Kaiapuni/ME-507-Project/README.md

# ME-507-Project
Controls a strip of Neopixel LEDs to respond to the motion of the wearer
