Kaiapuni/ME-507-Project/Eagle Files/ME507Board.png

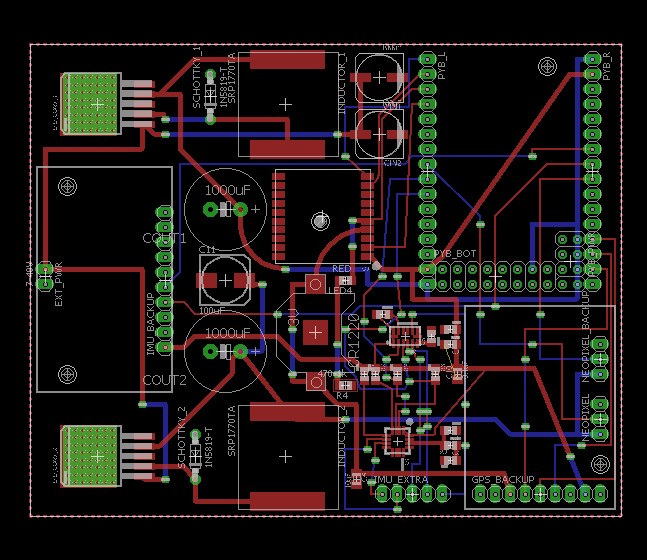
Eagle Files/ME507Board.png
