Kaiapuni/ME-507-Project/Eagle Files/ME507Schematic.png

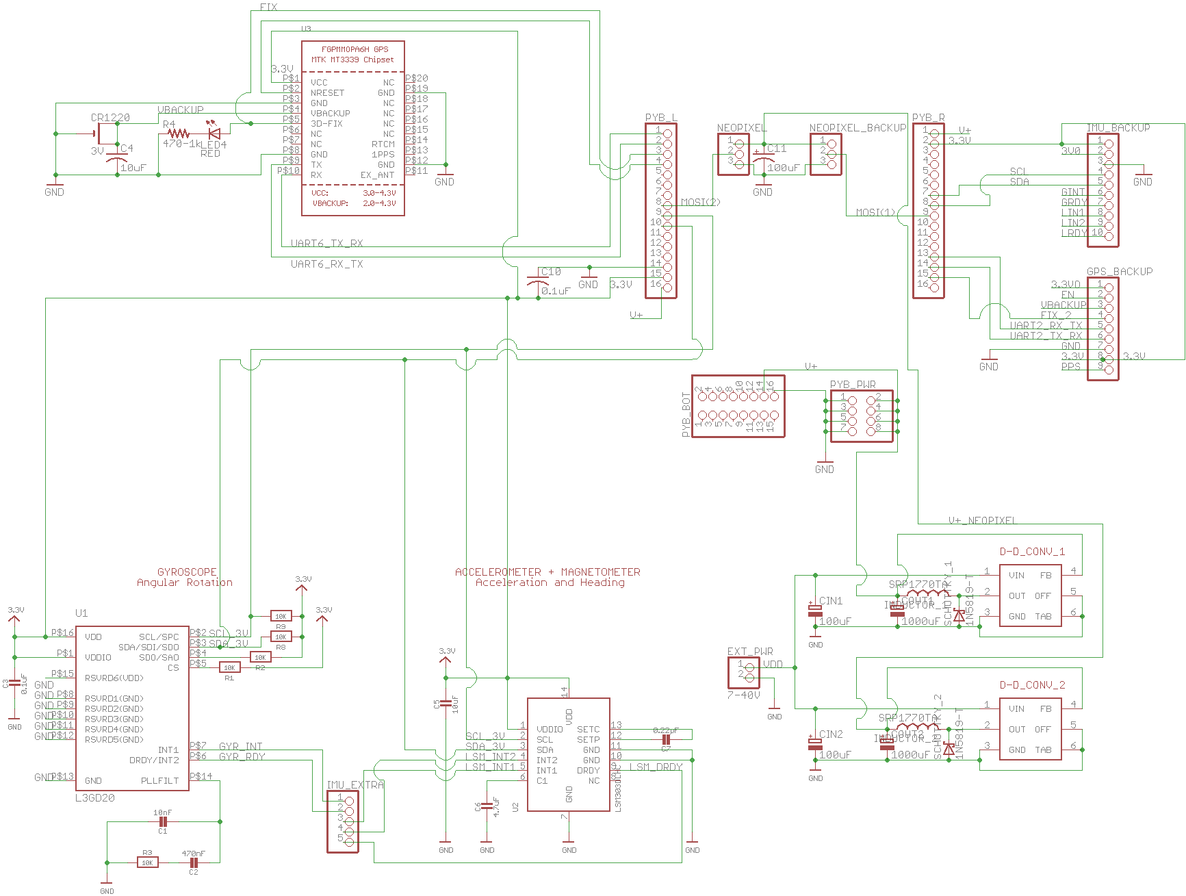
Eagle Files/ME507Schematic.png
