Kaiapuni/ME-507-Project/Eagle Files/Me507Project.brd

## EAGLE design Eagle Files/Me507Project.brd (2016-12-14)

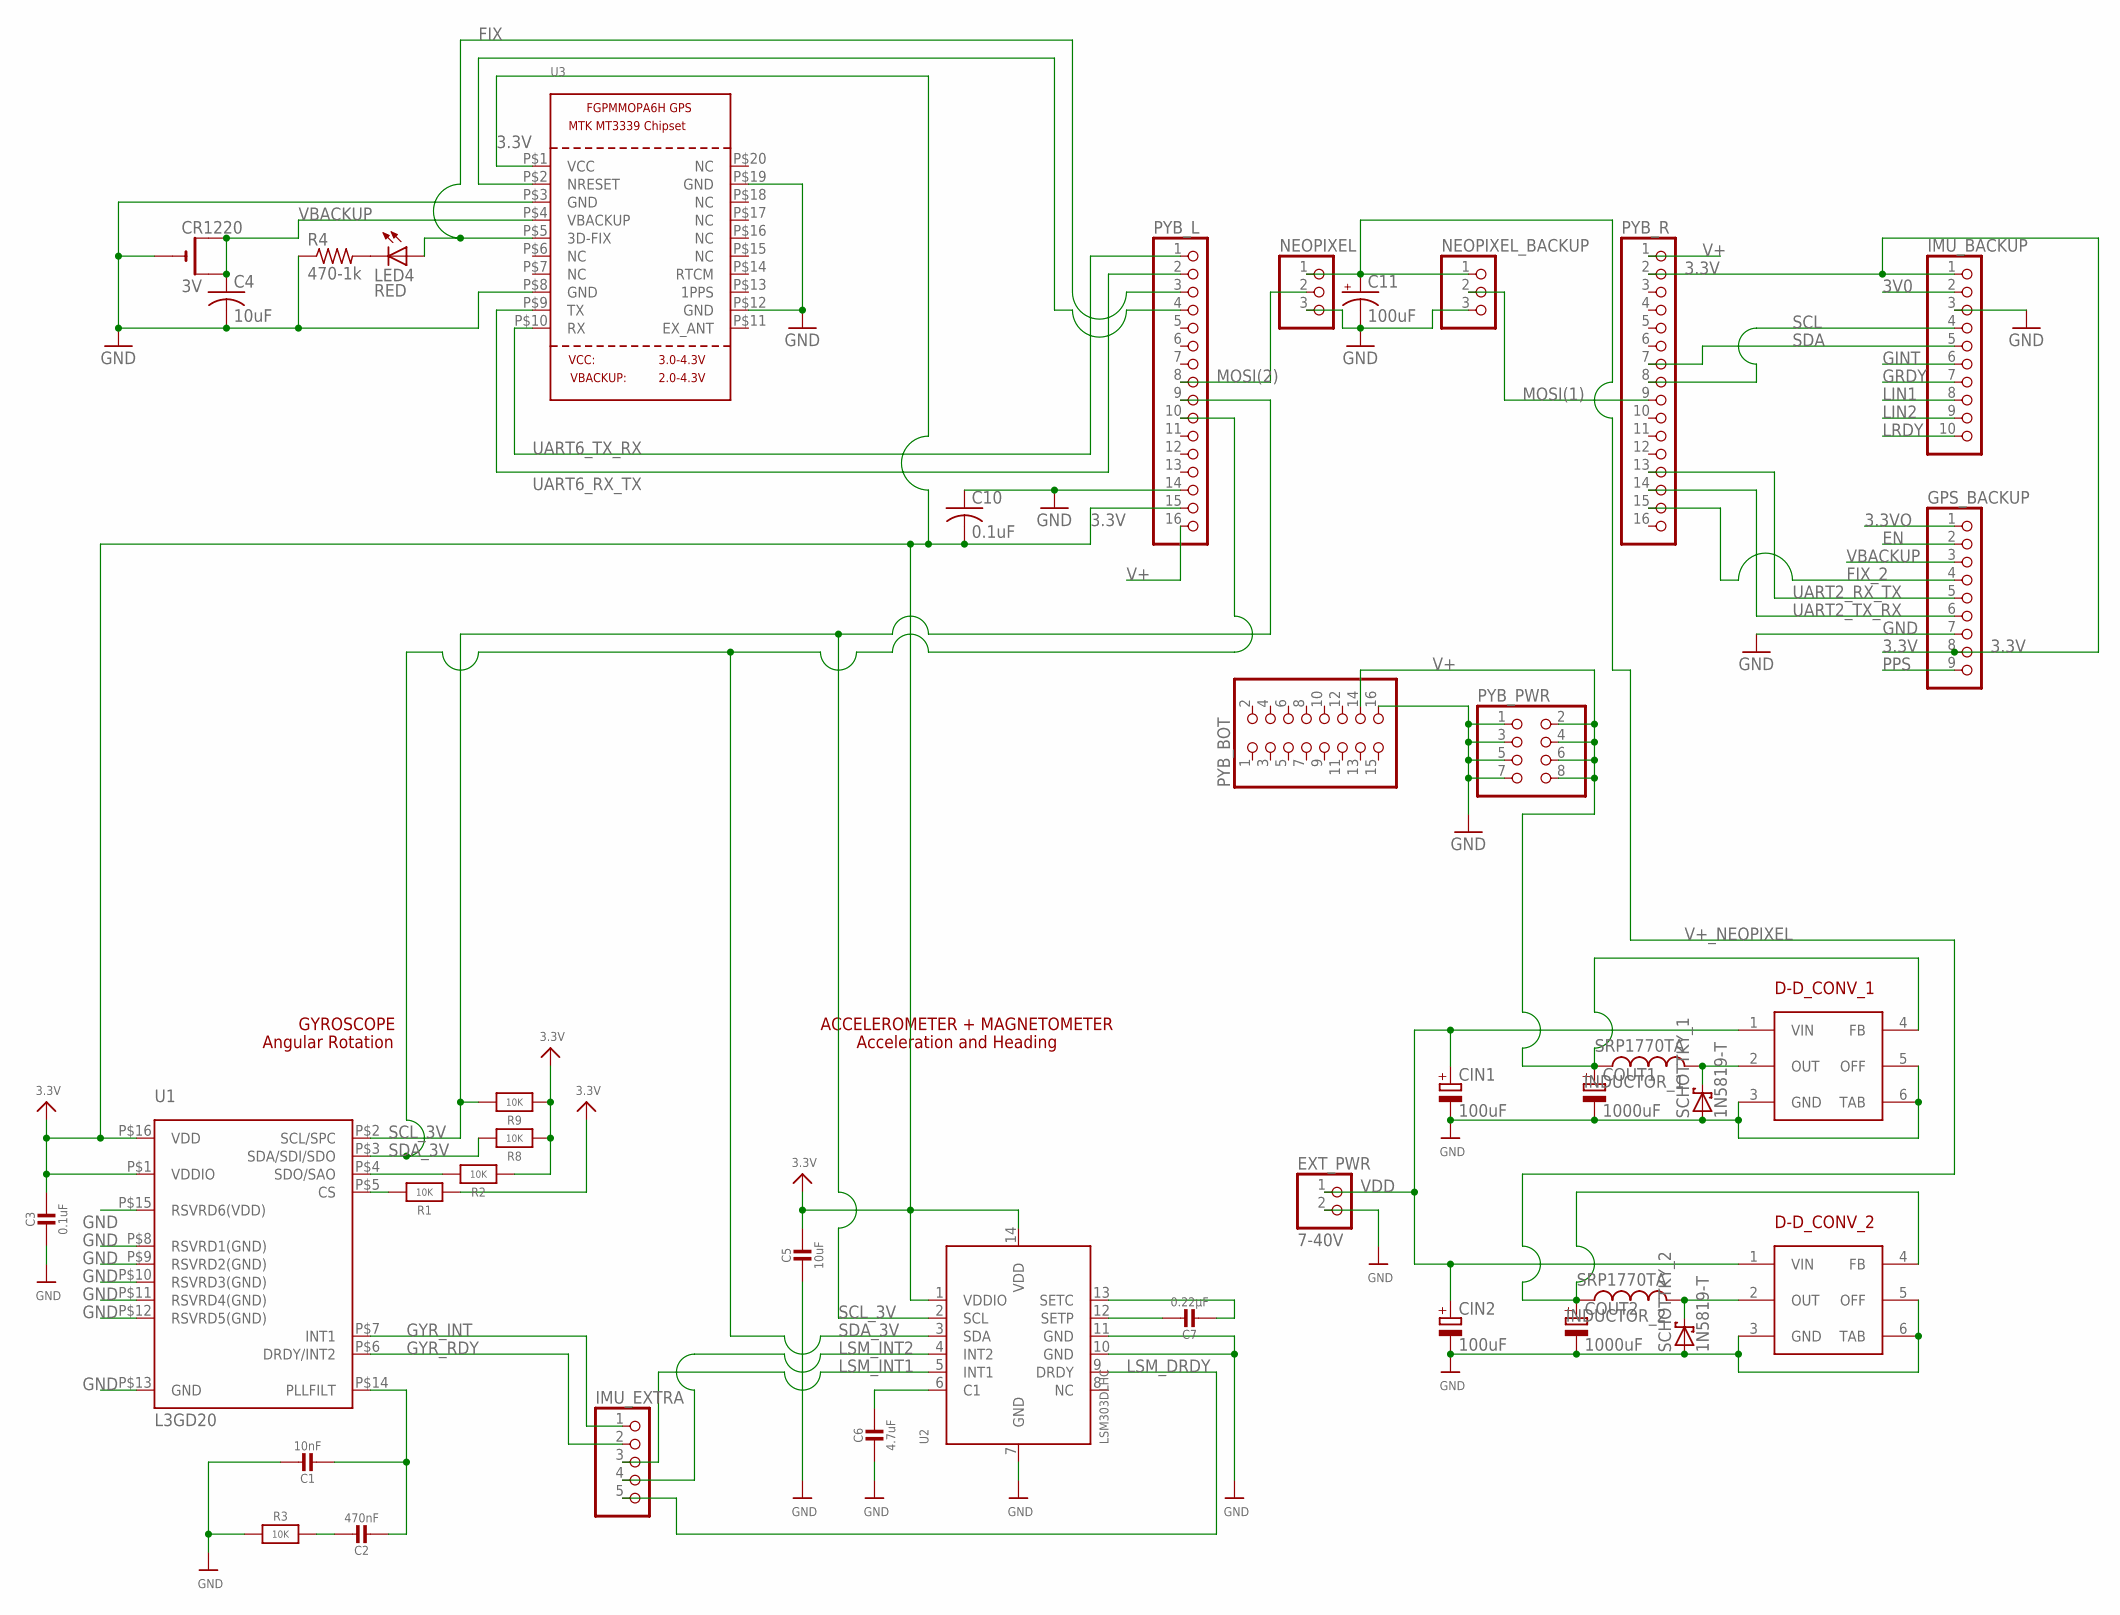
[picture p13: schematic Me507Project.sch]

Parts:
C1: 10nF; _0805MP
C2: 470nF; _0805MP
C3: 0.1uF; _0805MP
C4: 10uF; C0805K
C5: 10uF; _0805MP
C6: 4.7uF; _0805MP
C7: 0.22µF; _0805MP
C10: 0.1uF; C0805K
C11: 100uF; 153CLV-0810
CIN1, CIN2: 100uF; UD-8X10_NICHICON
COUT1, COUT2: 1000uF; E5-13
CR1220: 3V; CR1220-SMD
D-D_CONV_1, D-D_CONV_2: AP3003; TO263-5
EXT_PWR: 7-40V; 1X02
GPS_BACKUP: PINHD-1X9; 1X09
IMU_BACKUP: PINHD-1X10; 1X10
IMU_EXTRA: PINHD-1X5; 1X05
INDUCTOR_1, INDUCTOR_2: SRP1770TA
LED4: RED; CHIP-LED0805
NEOPIXEL: PINHD-1X3; 1X03
NEOPIXEL_BACKUP: PINHD-1X3; 1X03
PYB_BOT: PINHD-2X8; 2X08
PYB_L: PINHD-1X16; 1X16
PYB_PWR: PINHD-2X4; 2X04
PYB_R: PINHD-1X16; 1X16
R1, R2, R3, R8, R9: 10K; _0805MP
R4: 470-1k; R0805
SCHOTTKY_1, SCHOTTKY_2: 1N5819-T; DO41-7.6
U1: L3GD20; L3G4200D_LGA16L
U2: LSM303DLHC; LGA14
U3: GPS_FGPMMOPA6H; FGPMMOPA6H

Connections:
3.3V: C3.1, C5.1, C10.2, GPS_BACKUP.8, IMU_BACKUP.1, PYB_L.15, PYB_R.2, R1.1, R2.1, R8.1, R9.1, U1.P$1 (VDDIO), U1.P$16 (VDD), U2.1 (VDDIO), U2.14 (VDD), U3.P$1 (VCC)
3.3VO: GPS_BACKUP.1
3V0: IMU_BACKUP.2
EN: GPS_BACKUP.2
FIX: LED4.A, PYB_L.3, U3.P$5 (3D-FIX)
FIX_2: GPS_BACKUP.4, PYB_R.15
GINT: IMU_BACKUP.6
GND: C1.1, C3.2, C4.2, C5.2, C6.2, C10.1, C11.-, CIN1.-, CIN2.-, COUT1.-, COUT2.-, CR1220.-, D-D_CONV_1.3 (GND), D-D_CONV_1.5 (OFF), D-D_CONV_1.6 (TAB), D-D_CONV_2.3 (GND), D-D_CONV_2.5 (OFF), D-D_CONV_2.6 (TAB), EXT_PWR.2, GPS_BACKUP.7, IMU_BACKUP.3, NEOPIXEL.3, NEOPIXEL_BACKUP.3, PYB_BOT.16, PYB_L.14, PYB_PWR.1, PYB_PWR.3, PYB_PWR.5, PYB_PWR.7, R3.1, R4.1, SCHOTTKY_1.A, SCHOTTKY_2.A, U1.P$8 (RSVRD1(GND)), U1.P$9 (RSVRD2(GND)), U1.P$10 (RSVRD3(GND)), U1.P$11 (RSVRD4(GND)), U1.P$12 (RSVRD5(GND)), U1.P$13 (GND), U1.P$15 (RSVRD6(VDD)), U2.7 (GND), U2.10 (GND), U2.11 (GND), U3.P$3 (GND), U3.P$8 (GND), U3.P$12 (GND), U3.P$19 (GND)
GRDY: IMU_BACKUP.7
GYR_INT: IMU_EXTRA.1, U1.P$7 (INT1)
GYR_RDY: IMU_EXTRA.2, U1.P$6 (DRDY/INT2)
LIN1: IMU_BACKUP.8
LIN2: IMU_BACKUP.9
LRDY: IMU_BACKUP.10
LSM_DRDY: IMU_EXTRA.5, U2.9 (DRDY)
LSM_INT1: IMU_EXTRA.3, U2.5 (INT1)
LSM_INT2: IMU_EXTRA.4, U2.4 (INT2)
MOSI(1): NEOPIXEL_BACKUP.2, PYB_R.9
MOSI(2): NEOPIXEL.2, PYB_L.8
unnamed: R1.2, U1.P$5 (CS)
unnamed: R2.2, U1.P$4 (SDO/SAO)
unnamed: C2.1, R3.2
unnamed: C1.2, C2.2, U1.P$14 (PLLFILT)
unnamed: C7.1, U2.12 (SETP)
unnamed: C6.1, U2.6 (C1)
unnamed: C7.2, U2.13 (SETC)
unnamed: LED4.C, R4.2
unnamed: D-D_CONV_2.2 (OUT), INDUCTOR_2.P$4 (2), SCHOTTKY_2.C
unnamed: PYB_L.4, U3.P$2 (NRESET)
unnamed: D-D_CONV_1.2 (OUT), INDUCTOR_1.P$4 (2), SCHOTTKY_1.C
PPS: GPS_BACKUP.9
SCL: IMU_BACKUP.4, PYB_R.8
SCL_3V: PYB_L.9, R9.2, U1.P$2 (SCL/SPC), U2.2 (SCL)
SDA: IMU_BACKUP.5, PYB_R.7
SDA_3V: PYB_L.10, R8.2, U1.P$3 (SDA/SDI/SDO), U2.3 (SDA)
UART2_RX_TX: GPS_BACKUP.5, PYB_R.13
UART2_TX_RX: GPS_BACKUP.6, PYB_R.14
UART6_RX_TX: PYB_L.2, U3.P$9 (TX)
UART6_TX_RX: PYB_L.1, U3.P$10 (RX)
V+: COUT1.+, D-D_CONV_1.4 (FB), INDUCTOR_1.P$3 (1), PYB_BOT.14, PYB_L.16, PYB_PWR.2, PYB_PWR.4, PYB_PWR.6, PYB_PWR.8, PYB_R.1
V+_NEOPIXEL: C11.+, COUT2.+, D-D_CONV_2.4 (FB), INDUCTOR_2.P$3 (1), NEOPIXEL.1, NEOPIXEL_BACKUP.1
VBACKUP: C4.1, CR1220.+$1 (+), CR1220.+$2 (+1), GPS_BACKUP.3, U3.P$4 (VBACKUP)
VDD: CIN1.+, CIN2.+, D-D_CONV_1.1 (VIN), D-D_CONV_2.1 (VIN), EXT_PWR.1

Notes on the sheet:
GYROSCOPE
Angular Rotation
ACCELEROMETER + MAGNETOMETER
Acceleration and Heading

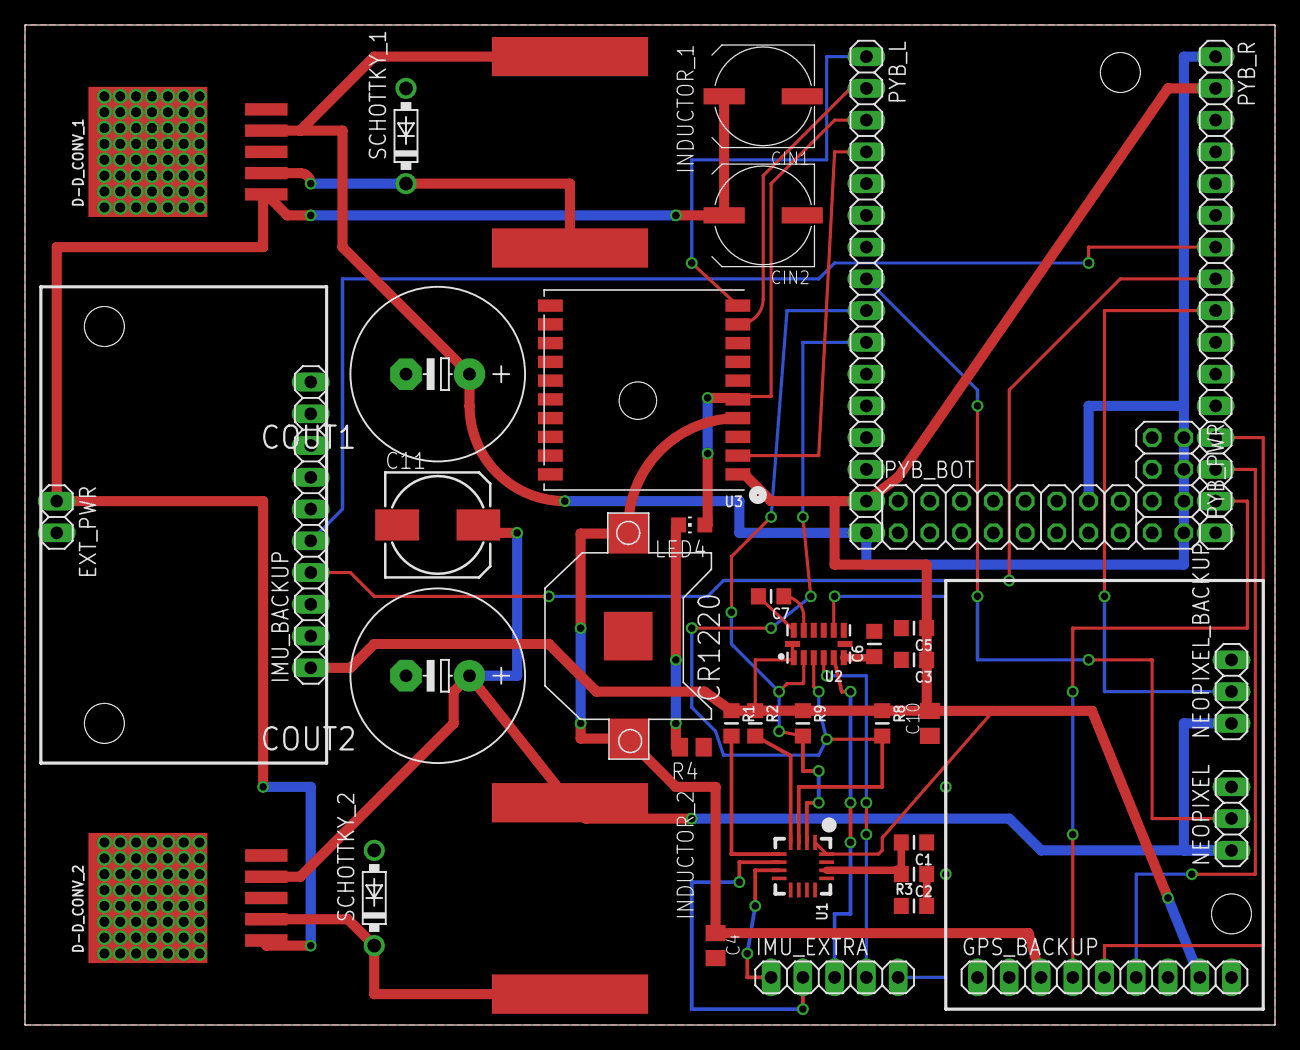
[picture p14: board Me507Project.brd from above]

Board: 2 copper layers, 100.0 x 80.0 mm, 40 parts (0 on the bottom side), 34 nets.
