Kaiapuni/ME-507-Project/boot.py

# boot.py -- run on boot-up
# can run arbitrary Python, but best to keep it minimal

import machine
import pyb
import imureader
import math
from ws2812 import WS2812
import time
import gpsreader
from micropyGPS import MicropyGPS
import lights
import ME_507_Project
import imumath
#pyb.main('main.py') # main script to run after this one
#pyb.usb_mode('CDC+MSC') # act as a serial and a storage device
#pyb.usb_mode('CDC+HID') # act as a serial device and a mouse


#gps = pyb.UART(6, 9600)
